0xnofoot/Intelligent-Climbing-Frame/README.md

# Intelligent-Climbing-Frame
智能爬架系统
该项目目的是在建筑施工工地的爬架上安装数据监测设备，该设备能够实时获取爬架的压力、各向偏移角度以及风向等数据，
并将数据打包发送至上位机处理。
