0xnofoot/Intelligent-Climbing-Frame/器件清单.xlsx

元件 | 型号/参数 | 单价 | 数量 | 总计 | 渠道 | 链接
主控stm32f4最小系统板(优信电子) | STM32F407VET6开发板 | 46.25 | 1 | 46.25 | 淘宝 | https://item.taobao.com/item.htm?spm=a1z09.2.0.0.3e992e8dv44BU1&id=585238891575&_u=m2j463qm9383
GPS模块 | ATGM336H | 35 | 1 | 35 | 淘宝 | https://item.taobao.com/item.htm?id=595353912203&_u=42j463qm194b
4G-DTU模块(成都亿佰特电子科技有限公司) | E840-TTL-4G02 | 178 | 1 | 178 | 淘宝 | https://item.taobao.com/item.htm?spm=a1z10.3-c-s.w4002-16785486399.55.687e51f6tJRJ8L&id=597197381263
二极管 | 1N4007 | 0.03 | 6 | 0.18 | 淘宝 | https://item.taobao.com/item.htm?spm=a1z09.2.0.0.3e992e8dv44BU1&id=522575684782&_u=m2j463qmc950
线性稳压器L7805CV | TO-220封装 | 0.48 | 1 | 0.48 | 淘宝 | https://item.taobao.com/item.htm?spm=a1z09.2.0.0.3e992e8dv44BU1&id=522575098847&_u=m2j463qm05b3
100uF普通直插电解电容 | 8*12MM | 0.08 | 1 | 0.08 | 淘宝 | https://item.taobao.com/item.htm?spm=a1z09.2.0.0.3e992e8dv44BU1&id=564996382588&_u=m2j463qm6536
1000uF普通直插电解电容 | 13*25MM | 0.54 | 1 | 0.54 | 淘宝 | https://item.taobao.com/item.htm?spm=a1z09.2.0.0.3e992e8dv44BU1&id=522579424493&_u=m2j463qmd342
104直插独石电容 | 脚距5.08MM | 0.03 | 2 | 0.06 | 淘宝 | https://item.taobao.com/item.htm?spm=a1z09.2.0.0.3e992e8dv44BU1&id=522575085023&_u=m2j463qm15a5
松乐继电器 | SRD-05V-SL-C | 0.88 | 2 | 1.76 | 淘宝 | https://item.taobao.com/item.htm?spm=a1z09.2.0.0.3e992e8dv44BU1&id=562878966880&_u=m2j463qm2599
直插三极管 | S9013 TO-92 NPN 25V/500mA 直插式 | 0.09 | 2 | 0.18 | 淘宝 | https://item.taobao.com/item.htm?spm=a1z09.2.0.0.3e992e8dv44BU1&id=578945150285&_u=m2j463qm23bd
3.6kΩ直插电阻 | 1/4W直插式 | 0.021 | 2 | 0.042 | 淘宝 | https://item.taobao.com/item.htm?spm=a1z10.3-c-s.w4002-21223910208.15.5ac96a4b0zNMoY&id=522573893081
460Ω直插电阻 | 1/4W直插式 | 0.021 | 2 | 0.042 | 淘宝 | https://item.taobao.com/item.htm?spm=a1z10.3-c-s.w4002-21223910208.13.5a7a6a4bXBbba2&id=522577712093
MAX3485 芯片 | MAX3485EESA SOIC-8封装 | 3.3 | 1 | 3.3 | 淘宝 | https://item.taobao.com/item.htm?spm=a1z09.2.0.0.3e992e8dv44BU1&id=548997892723&_u=m2j463qm8e81
120Ω贴片电阻 | 0805封装 贴片 | 0.02 | 1 | 0.02 | 淘宝 | https://item.taobao.com/item.htm?spm=a1z10.3-c-s.w4002-21223910208.13.43906a4bgIbaak&id=559833848081
0.1uF贴片电容 | 0805封装 贴片 | 0.1 | 1 | 0.1 | 淘宝 | https://item.taobao.com/item.htm?spm=a1z10.3-c-s.w4002-21223910208.13.6ee16a4bO0Fec1&id=522576784847
散热片 | TO-220封装三极管用 | 0.18 | 1 | 0.18 | 淘宝 | https://item.taobao.com/item.htm?spm=a1z09.2.0.0.3e992e8dv44BU1&id=522575037391&_u=m2j463qm5f81
天线转接头 | IPX转SMA | 4 | 2 | 8 | 淘宝 | https://item.taobao.com/item.htm?spm=a1z09.2.0.0.3e992e8dv44BU1&id=15871898103&_u=m2j463qme795
GPS天线 | SMA接口 | 16 | 1 | 16 | 淘宝 | https://item.taobao.com/item.htm?spm=a1z09.2.0.0.3e992e8dv44BU1&id=602345787921&_u=m2j463qm8b34
4G天线 | SMA接口 | 15 | 1 | 15 | 淘宝 | https://item.taobao.com/item.htm?spm=a1z09.2.0.0.3e992e8dv44BU1&id=576141326668&_u=m2j463qmbb99
AC-DC开关电源 | 220V转3.3V | 9 | 1 | 9 | 淘宝 | https://item.taobao.com/item.htm?spm=a1z09.2.0.0.4ce12e8d6d1jHt&id=564592490397&_u=g2j463qma8dc
排母 | 2.54*16，2*22P，180° | 0.44 | 2 | 0.88 | 淘宝 | https://item.taobao.com/item.htm?spm=a1z09.2.0.0.3e992e8dv44BU1&id=522576768218&_u=m2j463qm9655
排母 | 2.00*16，1*17P，180° | 0.17 | 1 | 0.17 | 淘宝 | https://item.taobao.com/item.htm?spm=a1z09.2.0.0.3e992e8dv44BU1&id=553979038844&_u=m2j463qm89a6
排母 | 2.00*16，1* 8P，180° | 0.08 | 1 | 0.08 | 淘宝 | https://item.taobao.com/item.htm?spm=a1z09.2.0.0.3e992e8dv44BU1&id=553979038844&_u=m2j463qm89a6
排母 | 2.54*16，1* 3P，180° | 0.03 | 1 | 0.03 | 淘宝 | https://detail.tmall.com/item.htm?id=41234671442&cm_id=140105335569ed55e27b&abbucket=18&skuId=3129099470951
排母 | 2.54*16，1* 4P，180° | 0.04 | 1 | 0.04 | 淘宝 | https://detail.tmall.com/item.htm?id=41234671442&cm_id=140105335569ed55e27b&abbucket=18&skuId=3129099470951
排针 | 2.54*16，1* 3P，180° | 0.03 | 5 | 0.15 | 淘宝 | https://item.taobao.com/item.htm?spm=a1z10.3-c-s.w4002-21223910208.22.40c96a4b2nXZVq&id=553875848479
排针 | 2.54*16，1* 5P，180° | 0.05 | 1 | 0.05 | 淘宝 | https://item.taobao.com/item.htm?spm=a1z10.3-c-s.w4002-21223910208.22.40c96a4b2nXZVq&id=553875848479
接线端子 | KF301 3P | 0.24 | 3 | 0.72 | 淘宝 | https://item.taobao.com/item.htm?spm=a1z09.2.0.0.3e992e8dv44BU1&id=554756924317&_u=m2j463qma9c3
接线端子 | KF301 2P | 0.12 | 2 | 0.24 | 淘宝 | https://item.taobao.com/item.htm?spm=a1z09.2.0.0.3e992e8dv44BU1&id=554756924317&_u=m2j463qma9c3
物联网SIM卡 |  | 未知 | 1 | 未知
打板 | 具体价格参考具体厂家 | 10 | 1 | 10
合计 |  |  |  | 326.574
