0xnofoot/Intelligent-Climbing-Frame/(list of files, drawings)

Other design files:
PCB工程/Master.PrjPCB
PCB工程/Master_Pcb.PcbDoc
PCB工程/Master_PcbLib.PcbLib
PCB工程/Master_Sch.SchDoc
PCB工程/Master_SchLib.SchLib
