0xnofoot/Intelligent-Climbing-Frame/源码/Src/main.c

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

/* Includes ------------------------------------------------------------------*/
#include "main.h"
#include "tim.h"
#include "usart.h"
#include "gpio.h"

/* USER CODE BEGIN Includes */
#include "callback.h" //回调
#include "task.h" //任务调度
#include "relay.h" //继电器
#include "server.h" //服务器/4G模块/串口1
#include "GPS.h" //GPS模块/串口3
#include "master.h" //主机启动相关
#include "shelf.h" //机器状态读取//串口5//RS485
#include "delay.h"//延时
#include "flash.h" //内部flash
/* USER CODE END Includes */


void SystemClock_Config(void);
/**
  * @brief  The application entry point.
  * @retval int
  */
int main(void)
{
  

  /* MCU Configuration--------------------------------------------------------*/

  /* Reset of all peripherals, Initializes the Flash interface and the Systick. */
  HAL_Init();

  /* Configure the system clock */
  SystemClock_Config();

  /* Initialize all configured peripherals */
  MX_GPIO_Init(); //GPIO初始化
  MX_TIM13_Init(); //TIM13初始化
  MX_TIM14_Init(); //TIM14初始化
  MX_UART4_Init(); //串口4初始化
  MX_USART1_UART_Init(); //串口1初始化
  MX_USART3_UART_Init(); //串口3初始化
  MX_UART5_Init(); //串口5初始化
  /* USER CODE BEGIN 2 */
//	printf("come");
	Relay_Init();//继电器初始化
	GPS_Init(); //GPS模块初始化
  RS485_Init();//RS485初始化
	Server_Init();//4G模块初始化
	Master_Init(); //完成开机任务
	Task_Init(); //任务调度初始化
  /* USER CODE END 2 */

  /* Infinite loop */
  /* USER CODE BEGIN WHILE */
  while (1)
  {
	Task_Handle(); //任务调度
    /* USER CODE END WHILE */

    /* USER CODE BEGIN 3 */
  }
  /* USER CODE END 3 */
}

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
