0xnofoot/Intelligent-Climbing-Frame/源码/Inc/main.h

#define Ser_RST_Pin GPIO_PIN_4
#define Ser_RST_GPIO_Port GPIOE
#define Ser_IO_RT_Pin GPIO_PIN_5
#define Ser_IO_RT_GPIO_Port GPIOE
#define GPS_PPS_Pin GPIO_PIN_7
#define GPS_PPS_GPIO_Port GPIOE
#define Ser_STAT_Pin GPIO_PIN_11
#define Ser_STAT_GPIO_Port GPIOE
#define Ser_LIKA_Pin GPIO_PIN_12
#define Ser_LIKA_GPIO_Port GPIOE
#define Ser_LIKB_Pin GPIO_PIN_13
#define Ser_LIKB_GPIO_Port GPIOE
#define Ser_LIKC_Pin GPIO_PIN_14
#define Ser_LIKC_GPIO_Port GPIOE
#define Ser_LIKD_Pin GPIO_PIN_15
#define Ser_LIKD_GPIO_Port GPIOE
#define Relay2_Pin GPIO_PIN_12
#define Relay2_GPIO_Port GPIOB
#define Relay1_Pin GPIO_PIN_13
#define Relay1_GPIO_Port GPIOB
#define AUX_Pin GPIO_PIN_7
#define AUX_GPIO_Port GPIOB
#define LORA_M0_Pin GPIO_PIN_8
#define LORA_M0_GPIO_Port GPIOB
#define LORA_M1_Pin GPIO_PIN_9
#define LORA_M1_GPIO_Port GPIOB
#define RS485_RE_Pin GPIO_PIN_0
#define RS485_RE_GPIO_Port GPIOE
#define RS485_DE_Pin GPIO_PIN_1
#define RS485_DE_GPIO_Port GPIOE
#define Rise_Check_Pin GPIO_PIN_5
#define Rise_Check_GPIO_Port GPIOB
